FLepetitAimon/CarboEye/Documents techniques/image/circuit_zener.png

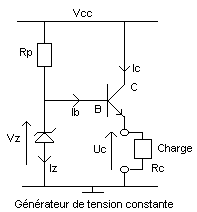
Documents techniques/image/circuit_zener.png
