FLepetitAimon/CarboEye/Documents techniques/image/schema_AD7714.PNG

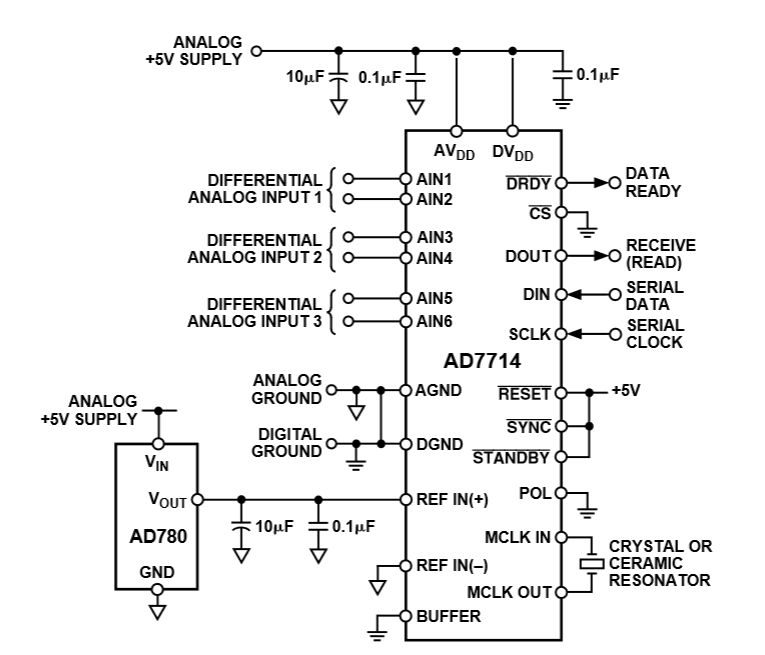
Documents techniques/image/schema_AD7714.PNG
