FLepetitAimon/CarboEye/Documents techniques/image/schema_coupe.PNG

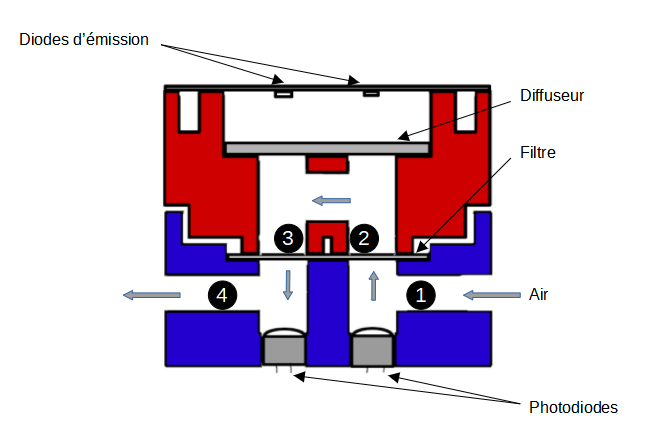
Documents techniques/image/schema_coupe.PNG
