FLepetitAimon/CarboEye/FreeCAD/fichier FreeCAD/AssemblageCarbonEye.FCStd

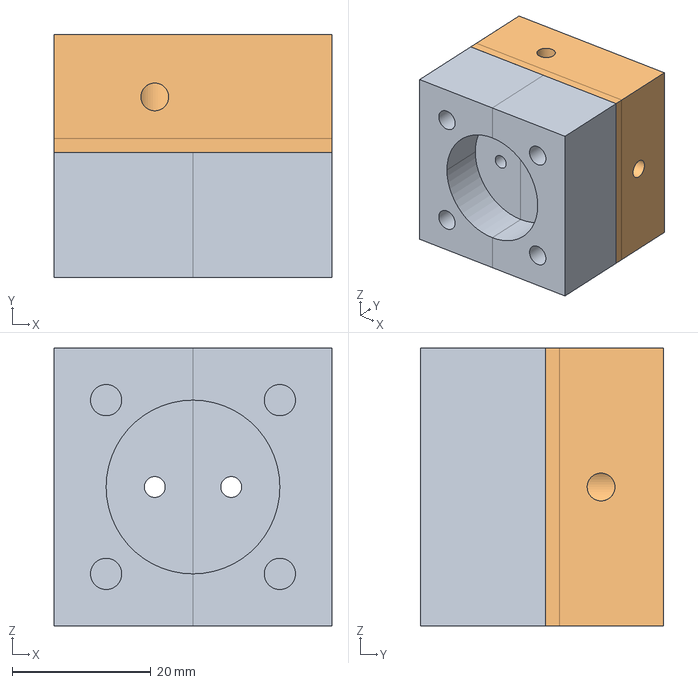
[picture p16: CAD file, 2021-07-09]
FreeCAD/fichier FreeCAD/AssemblageCarbonEye.FCStd
40.0 x 35.0 x 40.0 mm
supportDiode_001
motier supportPhotodiode_001
