FLepetitAimon/CarboEye/FreeCAD/fichier FreeCAD/motier supportPhotodiode.FCStd

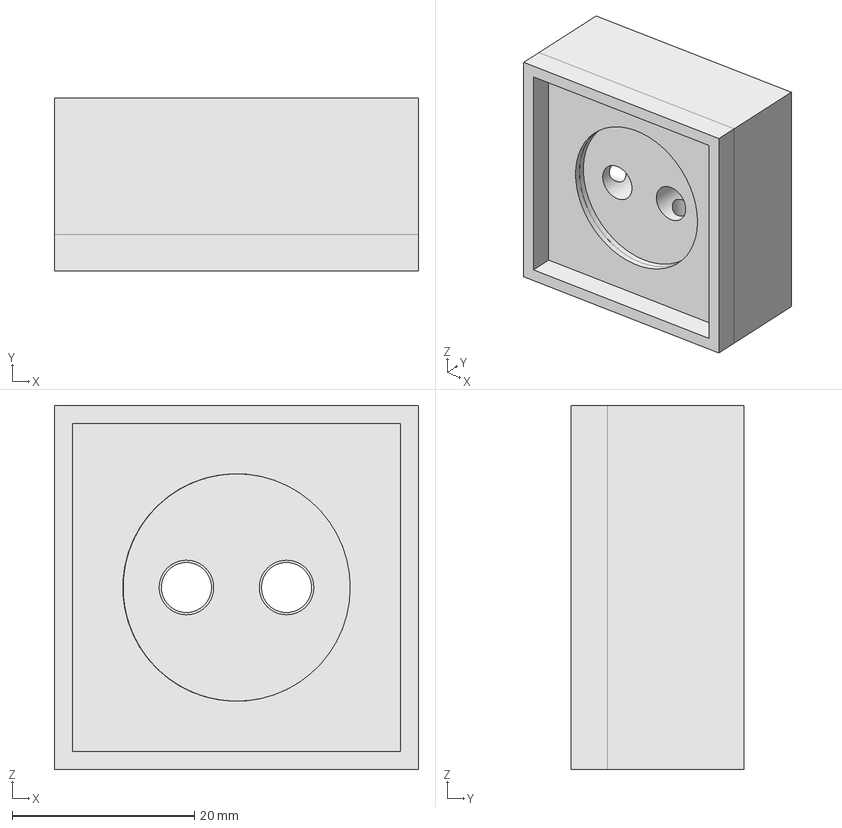
[picture p17: CAD file, 2021-08-04]
FreeCAD/fichier FreeCAD/motier supportPhotodiode.FCStd
40.0 x 19.0 x 40.0 mm
