FLepetitAimon/CarboEye/FreeCAD/fichier stl/supportDiode_1.2.stl

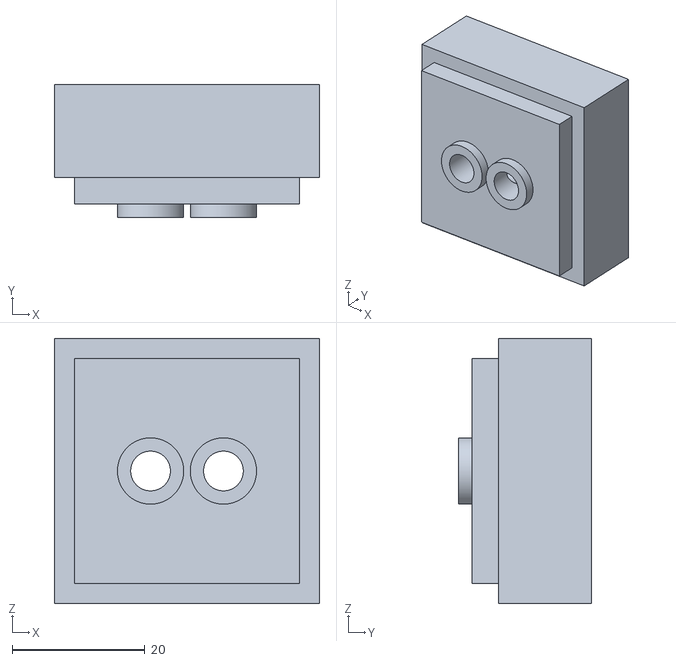
[picture p18: CAD file, 2021-08-04]
FreeCAD/fichier stl/supportDiode_1.2.stl
40.0 x 20.0 x 40.0
