FLepetitAimon/CarboEye/FreeCAD/fichier stl/supportPhotodiode_1.2.stl

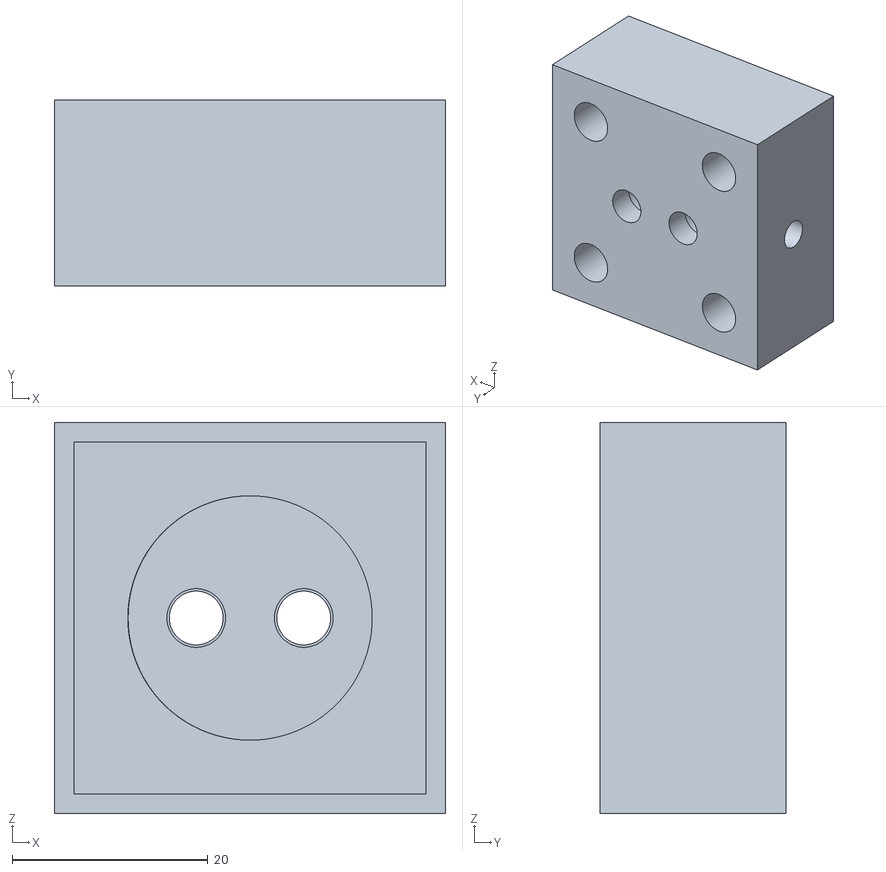
[picture p19: CAD file, 2021-08-04]
FreeCAD/fichier stl/supportPhotodiode_1.2.stl
40.0 x 19.0 x 40.0
