FLepetitAimon/CarboEye/FreeCAD/fichier stl/supportDiode_1.1.stl

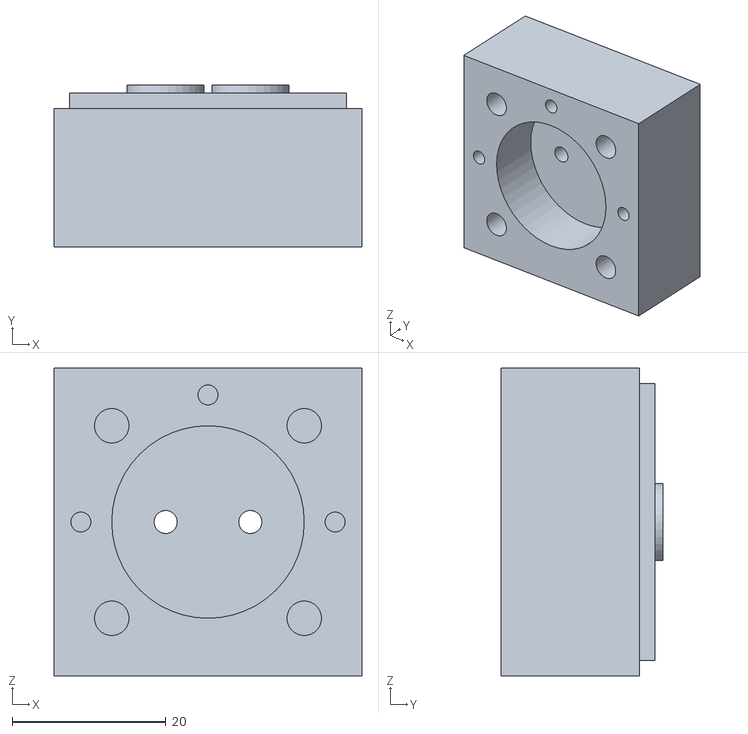
[picture p20: CAD file, 2021-07-19]
FreeCAD/fichier stl/supportDiode_1.1.stl
40.0 x 21.0 x 40.0
