FLepetitAimon/CarboEye/FreeCAD/fichier stl/supportPhotodiode_1.1.stl

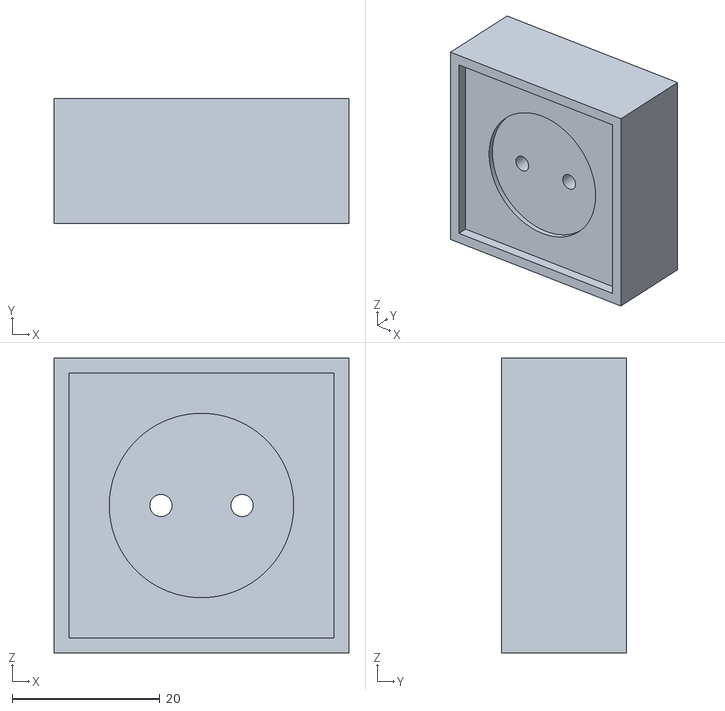
[picture p21: CAD file, 2021-07-19]
FreeCAD/fichier stl/supportPhotodiode_1.1.stl
40.0 x 17.0 x 40.0
