FLepetitAimon/CarboEye/(list of files, cad)

Other CAD files:
FreeCAD/fichier FreeCAD/supportDiode.FCStd
