FLepetitAimon/CarboEye/Gestion de Projet/Journal de bord.odt

Mardi 03/08

étude des différents adc. Stabilité de la réponse à une tension de 5V, L’adc 16bits a une variation importante, autour de 5mV, tandis ce que l’AD7714 varie de 30uV.

Rmq : La tension 5V est la même que la tension d’alimentation tester avec 2 sources de tension différentes.

Stabilité de la réponse avec les photodiodes, pour l’AD7714 variation de 1mV. Implique une imprécision de 1ug/m³ sur la mesure finale (T=60s;d=3mm). Trop d’imprécision, deux sources d’erreur : l’amplification du signal photodiode, mauvaise stabilité du signal photodiode.

Test complémentaire : remplacer la photodiode par un générateur de courant stable. Tester sur un PCB et non sur une plaquette d’essai.

Mercredi04/08

Matin :

- Dessin de la pièce 3D avec les dimensions mises à jour : trou aimant, trou diffuseur, trou conduit, méplat cadre et conduit, photodiode.

→ Prêt à imprimer

- Avancement Dessin PCB du circuit d’amplification photodiode. Remplacement de l’adc 16bit par l’adc 24bits SPI.

Reste à faire:

→ ajout d’un connecteur pour faire le test avec générateur de courant constant. Peut-être sur une autre piste ?

→ gestion des LEDs

→ Penser aux vis de fixation

Jeudi 05/08

Matin :

- test de stabilité de la mesure de tension par l’ad7714 avec une source extérieure.

Rmq :

→ variation de la mesure d’environ 2mV sur les 5V d’un autre arduino. Les tensions d’alimentation des arduino sont peu stable. En mesurant avec un multimètre la tension 5V de l’arduino varie de quelques mV. Il est nécessaire d’ajouter un circuit à base de diode zener pour stabiliser la tension d’alimentation.

→ la tension mesurée par l’ad7714 n’est pas bonne, il y a un problème avec la tension de référence qui chute lorsqu’on la branche au canal AIN6.

Reste à faire :

→ modifier la tension de référence pour qu’elle soit stable à 2.5V

→ ajouter un circuit de stabilisation de tension avec diode zener

LUNDI 09/08

Matin :

- amélioration de l’exactitude de la mesure de tension par l’ad7714

Rmq :

→ Avec une tension de référence stable, il est possible de trouver les bons coefficients pour convertir la sortie numérique en une tension exacte. Ces coefficients sont accessibles expérimentalement.

→ Parfois l’AD7714 plante et renvoie des valeurs aberrantes. La fonction reset corrige se problème.

- mesure avec le circuit amplificateur.

→ Variation de l’ordre du mV. Cette variation vient très certainement du circuit d’amplification ,puisque nous avons vu que la mesure d’une tension stable par l’adc était sable. Il peux y avoir deux sources, l’instabilité de la tension d’offset qui est issu de la tension de l’arduino. Ou le bruit de la plaquette d’essai. En enlevant la tension d’offset, et en courcircuitant les photodiodes on retombe sur des variation d’un digit. Avec les photodiodes on des variations de 0.5mV à 1mV. Ces variation.sont en partie du au bruit lumineux ambiant.

Reste à faire :

→ tester le circuit d’amplification avec un générateur de courant constant.

→ alimenter l’ensemble du circuit par une source de tension constante.

LUNDI 09/08

Matin :

- réflexion sur la géométrie du capteur

Rmq :

→ diffuseur inutile s’il est placé contre les trou des conduits. Il faudrait l’éloigner pour qu’il soit utile.

→ Remise en cause de la diffusion de la lumière. La diffusion de la lumière diminue la directionnalité du faisceau. Or comme le canal est fin et long l’intensité lumineuse en sortie du conduit est trop faible pour être mesuré. Il faut donc plutôt miser sur un faisceau directionnel.

→ deuxième problème : les deux diodes (infra-rouge et bleue) doivent se trouver en face du trou pour permettre la propagation de la lumière.

→ deux solutions à tester : agrandir la taille des trous et enlever le diffuseur. OU placé une cloison fine entre les deux trous, et avoir un sas pour le flux d’air beaucoup plus large et rectangulaire

→ la gestion de plusieurs longueurs d’onde peut se faire sur la photodiode. On émet une lumière blanche avec la diode et reçoit le signal sur des récepteurs multicolore découpé en pixel. Comme les récepteurs d’appareil photo par exemple.
