FLepetitAimon/CarboEye/CircuitPrincipaleCarbonEye/circuitLedCarbonEye/circuitLedCarbonEye.pdf

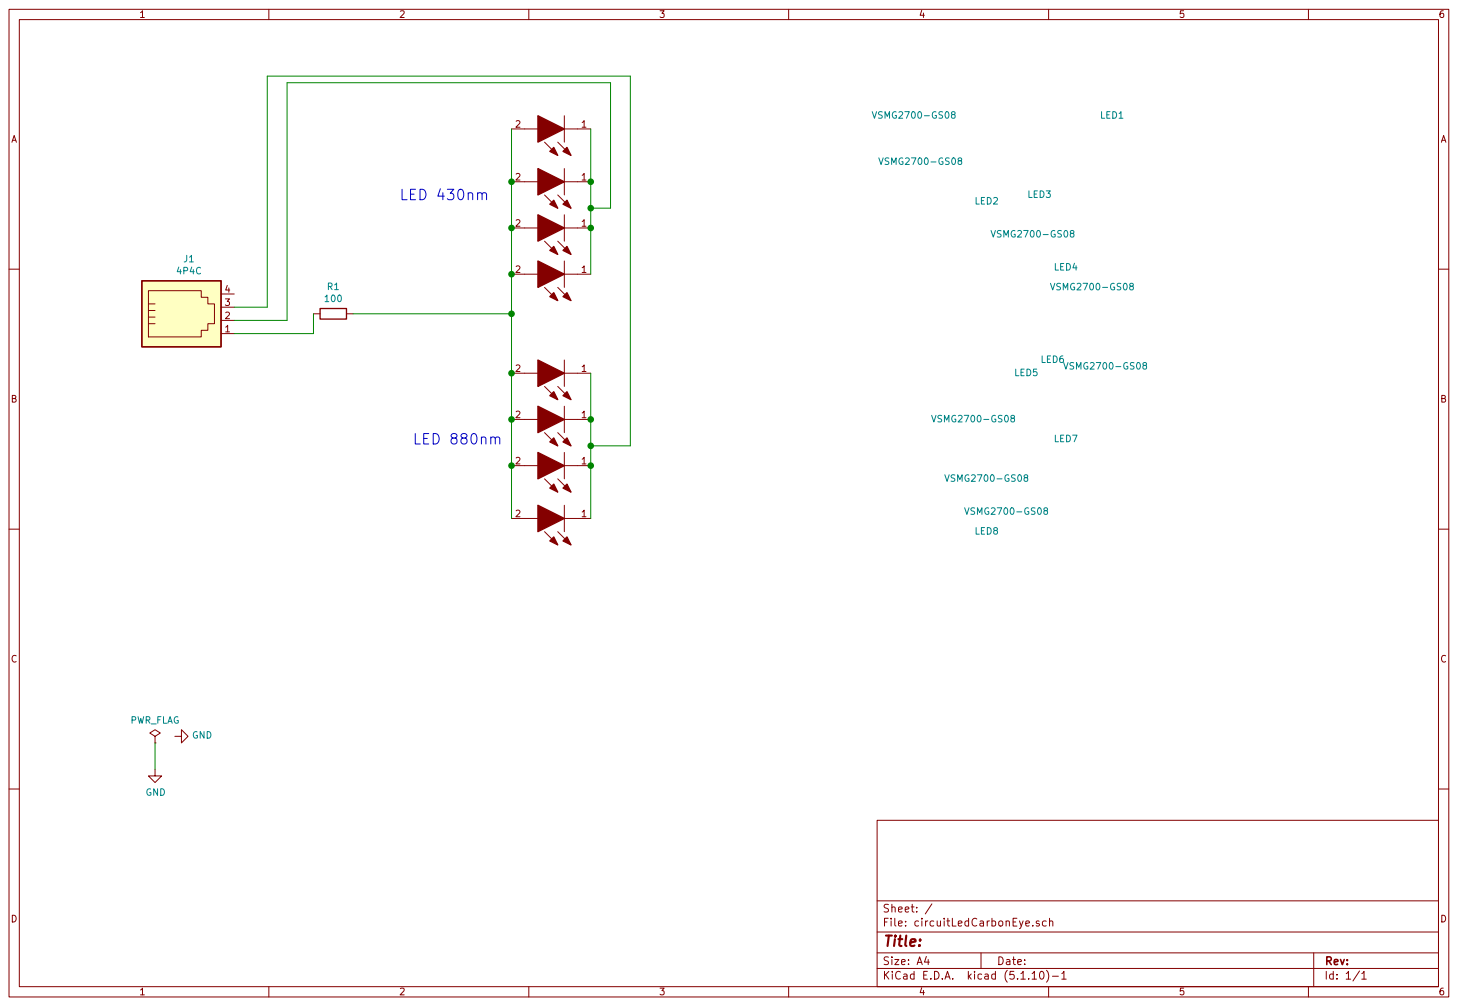
[picture p22: page 1]

File: circuitLedCarbonEye.sch Sheet: /
Id: 1/1 Title:
