FLepetitAimon/CarboEye/CircuitPrincipaleCarbonEye/circuitLedCarbonEye/pdf/circuitLedCarbonEye-F_Cu.pdf

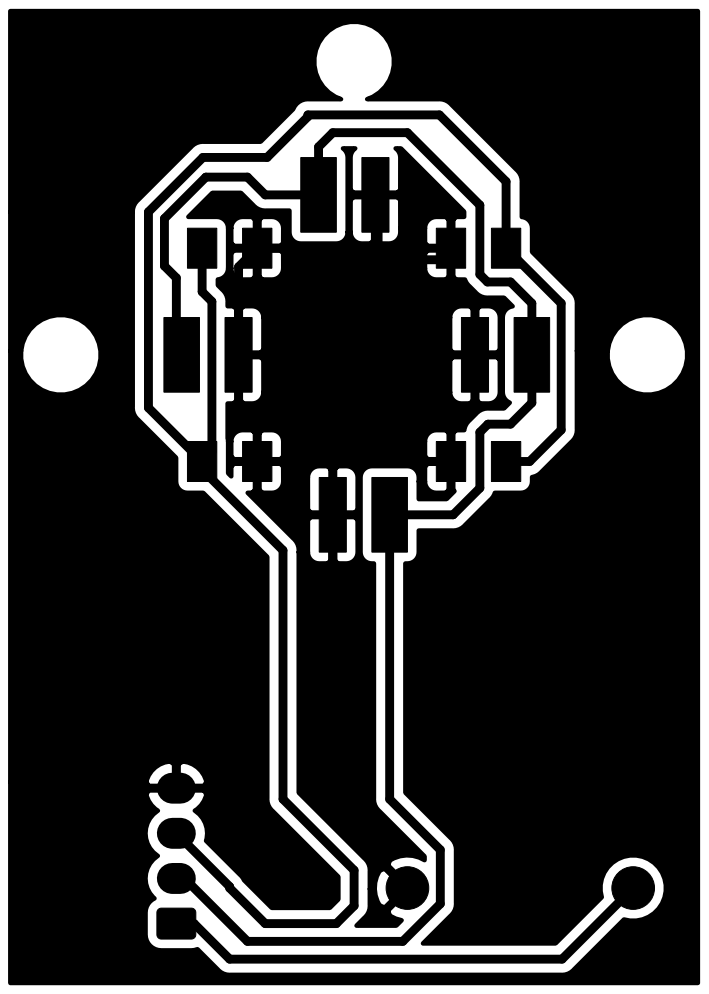
[picture p23: page 1]
