FLepetitAimon/CarboEye/CircuitPrincipaleCarbonEye/circuitLedCarbonEye/pdf/circuitLedCarbonEye-F_SilkS.pdf

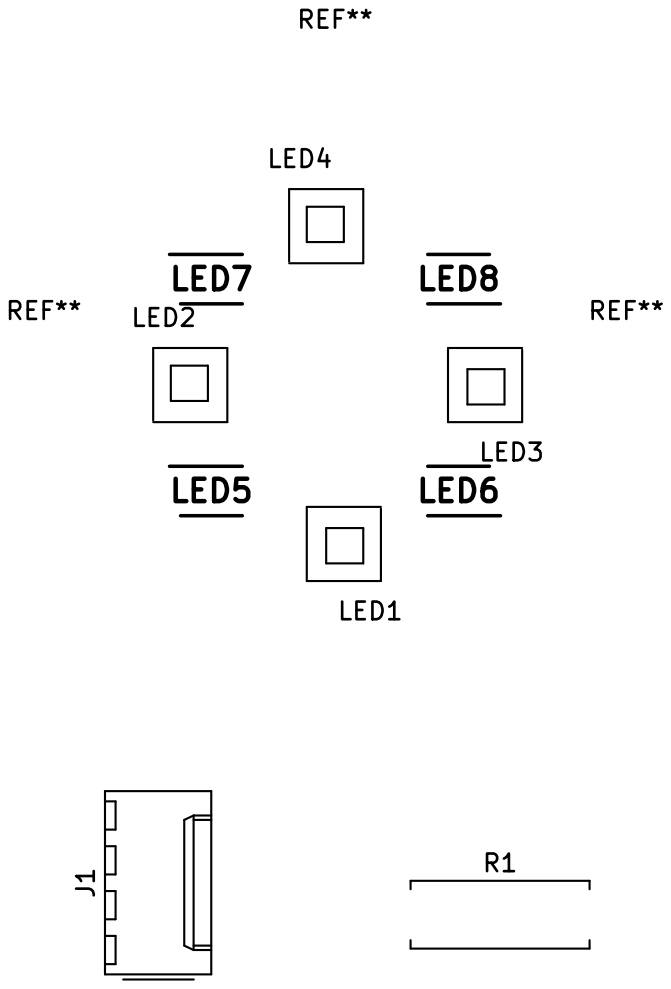
[picture p24: page 1]
