FLepetitAimon/CarboEye/CircuitPrincipaleCarbonEye/circuitLedCarbonEye/circuitLedCarbonEye.kicad_pcb

## KiCad design CircuitPrincipaleCarbonEye/circuitLedCarbonEye/circuitLedCarbonEye.kicad_pcb (2021-07-19)

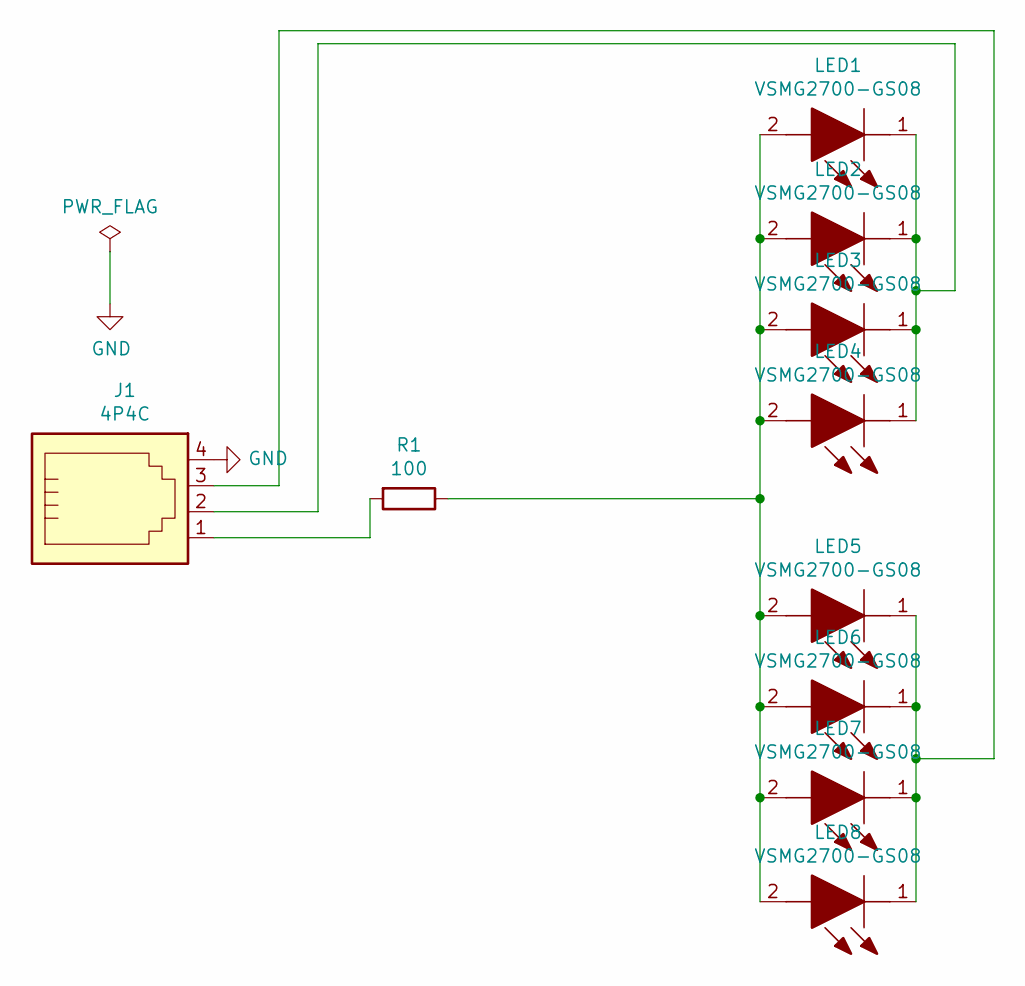
[picture p25: schematic circuitLedCarbonEye.sch]

Parts:
J1: 4P4C; Molex_KK-254_AE-6410-04A_1x04_P2.54mm_Vertical
LED1, LED2, LED3, LED4: VSMG2700-GS08; LED_CMS_L4.2mm_W4.2mm; Manufacturer_Part_Number VSMG2700-GS08
LED5, LED6, LED7, LED8: VSMG2700-GS08; LEDM3528X185N; Manufacturer_Part_Number VSMG2700-GS08
R1: 100; R_Axial_DIN0411_L9.9mm_D3.6mm_P12.70mm_Horizontal

Connections:
GND: J1.4
unnamed: J1.1, R1.2
unnamed: J1.2, LED1.1, LED2.1, LED3.1, LED4.1
unnamed: J1.3, LED5.1, LED6.1, LED7.1, LED8.1
unnamed: LED1.2, LED2.2, LED3.2, LED4.2, LED5.2, LED6.2, LED7.2, LED8.2, R1.1

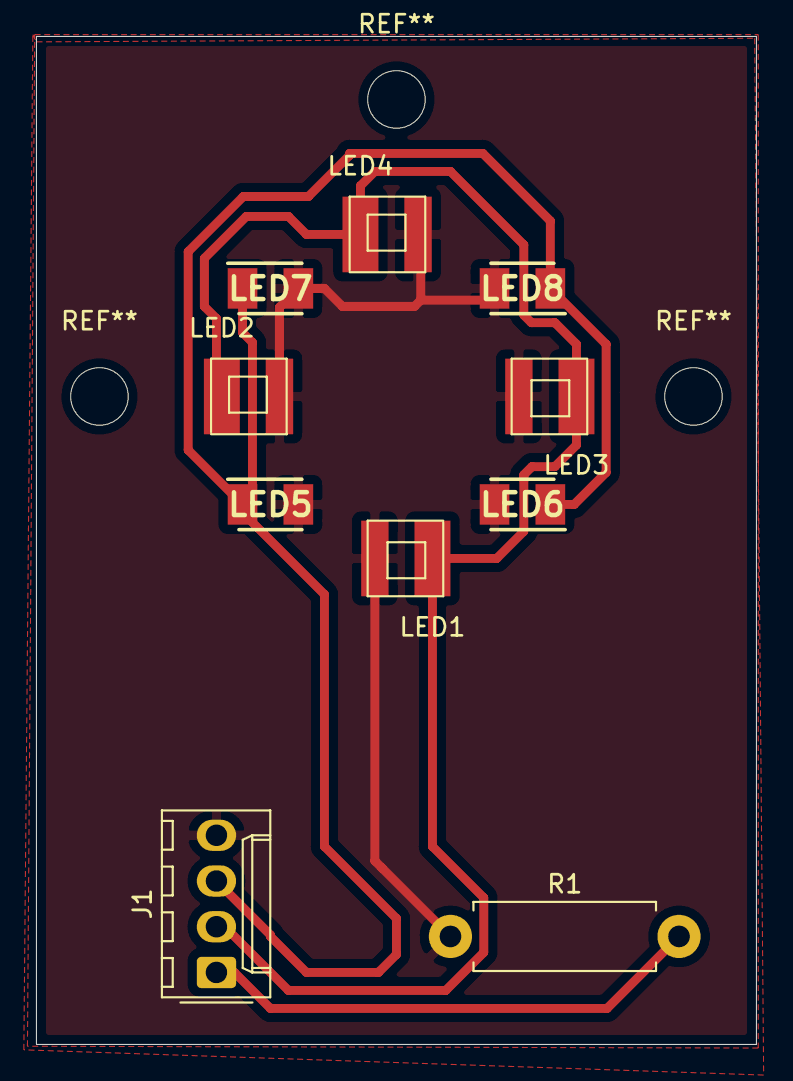
[picture p26: board circuitLedCarbonEye.kicad_pcb from above]

Board: 2 copper layers, 40.0 x 56.0 mm, 10 parts (0 on the bottom side), 4 nets.
