FLepetitAimon/CarboEye/(commit log)

2021-07-09 FreeCAD V2.0
    [AssemblageCarbonEye.FCStd, motier supportPhotodiode.FCStd, supportDiode.FCStd]
2021-07-09 circuitPrincipaleKiCAD V1.0.1
    [CircuitPrincipaleCarbonEye.sch]
2021-07-09 KiCAD nettoyage dossier librairie
2021-07-09 CircuitLed V1.0
    [CircuitPrincipaleCarbonEye.sch, circuitLedCarbonEye.kicad_pcb, circuitLedCarbonEye.sch, supportDiode.FCStd]
2021-07-12 KICAD RoutageCircuit led V1.0
    [CircuitPrincipaleCarbonEye.kicad_pcb, CircuitPrincipaleCarbonEye.sch, boitier.FCStd, circuitLedCarbonEye.kicad_pcb, debitmetre.FCStd, pompe RS.FCStd, pompe sensidyne25.FCStd]
2021-07-12 FreeCAD support photodiode - diamètre 3mm canal
    [motier supportPhotodiode.FCStd]
2021-07-15 Mise à jour circuitled et piece 3D pour premiere impression
    [AssemblageCarbonEye.FCStd, motier supportPhotodiode.FCStd, supportDiode.FCStd, supportDiode.stl, supportPhotodiode.stl]
2021-07-15 mise à jour circuit led pour premiere impresson
    [circuitLedCarbonEye.kicad_pcb]
2021-07-19 vérification avant impression 1
    [circuitLedCarbonEye.kicad_pcb, circuitLedCarbonEye.sch, motier supportPhotodiode.FCStd, supportDiode.FCStd, supportDiode.stl, supportPhotodiode.stl]
2021-07-27 post premier_test
    [CircuitPrincipaleCarbonEye.sch]
2021-08-02 adc spi
2021-08-04 ADC 24bits, SPI
    [CircuitPrincipaleCarbonEye.sch, motier supportPhotodiode.FCStd, supportDiode.FCStd, supportDiode_1.1.stl, supportDiode_1.2.stl, supportPhotodiode_1.1.stl, supportPhotodiode_1.2.stl]
2021-08-04 mises à jour fichier stl
    [supportDiode_1.2.stl]
2021-08-05 journal de bord 05/08
2021-08-08 test adc
2021-08-09 nouveau coefficient pour tension exact
2021-08-10 journal de bord 10/08
